felixzhong94/NVSL-quadcopter_lab5/PartList.xlsx

Description | DATASHEET | DIST | DISTPN | MFR | MPN | VALUE | Lab04 | Lab04a
Light emitting diode | http://media.digikey.com/pdf/Data%20Sheets/Lite-On%20PDFs/LTST-C170EKT.pdf | Digikey | 160-1178-1-ND | Lite-On Inc | LTST-C170EKT | red | x | x
Light emitting diode | http://media.digikey.com/pdf/Data%20Sheets/Lite-On%20PDFs/LTST-C170GKT.pdf | Digikey | 160-1179-1-ND | Lite-On Inc | LTST-C170GKT | green |  | x
Resistor | http://media.digikey.com/pdf/Data%20Sheets/Yageo%20PDFs/RC0805%20Pb%20Free.pdf | Digikey | 311-0.0ARCT-ND | Yageo | RC0805JR-070RL | 0 | x | x
Resistor | http://media.digikey.com/pdf/Data%20Sheets/Yageo%20PDFs/RC0805%20Pb%20Free.pdf | Digikey | 311-100ARCT-ND | Yageo | RC0805JR-07100RL | 100 |  | x
Resistor | http://media.digikey.com/pdf/Data%20Sheets/Yageo%20PDFs/RC0805%20Pb%20Free.pdf | Digikey | 311-10KARCT-ND | Yageo | RC0805JR-0710KL | 10K |  | x
Resistor | http://media.digikey.com/pdf/Data%20Sheets/Yageo%20PDFs/RC0805%20Pb%20Free.pdf | Digikey | 311-330ARCT-ND | Yageo | RC0805JR-07330RL | 330 |  | x
Resistor | http://media.digikey.com/pdf/Data%20Sheets/Yageo%20PDFs/RC0805%20Pb%20Free.pdf | Digikey | 311-5.1KARCT-ND | Yageo | RC0805JR-075K1L | 5.1K |  | x
2 pin single inline pin header, socket, or connector | http://multimedia.3m.com/mws/mediawebserver?66666UuZjcFSLXTtNxTElX&VEVuQEcuZgVs6EVs6E666666-- | Digikey | 3M9447-ND | 3M | 961102-6404-AR |  | x | x
Pushbutton with 2 pins shorting 1 to 2 and two extra mounting pins 3 & 4 | http://www.te.com/commerce/DocumentDelivery/DDEController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 | Digikey | 450-1129-ND | TE Connectivity Alcoswitch Switches | FSM4JSMA |  |  | x
Polarized capacitor | http://www.avx.com/docs/Catalogs/taj.pdf | Digikey | 478-1677-1-ND | AVX Corporation | TAJB107K006RNJ | 100uF | x | x
Polarized capacitor | http://www.avx.com/docs/Catalogs/taj.pdf | Digikey | 478-8912-1-ND | AVX Corporation | TAJD227K006RNJ | 220uF |  | x
Nonpolarized capacitor | http://www.murata.com/~/media/webrenewal/support/library/catalog/products/capacitor/mlcc/c02e.ashx | Digikey | 490-1666-1-ND | Murata Electronics North America | GRM21BR71H104KA01L | 0.1uF |  | x
Nonpolarized capacitor | http://www.murata.com/~/media/webrenewal/support/library/catalog/products/capacitor/mlcc/c02e.ashx | Digikey | 490-1670-1-ND | Murata Electronics North America | GRM21BR71H224KA01L | 0.22uF |  | x
Nonpolarized capacitor | http://www.murata.com/~/media/webrenewal/support/library/catalog/products/capacitor/mlcc/c02e.ashx | Digikey | 490-3335-1-ND | Murata Electronics North America | GRM21BR61E475KA12L | 4.7uF |  | x
Nonpolarized capacitor | http://search.murata.co.jp/Ceramy/image/img/A01X/G101/ENG/GQM2195C2AR75CB01-01.pdf | Digikey | 490-3585-1-ND | Murata Electronics North America | GQM2195C2AR75CB01D | 0.75pF |  | x
Nonpolarized capacitor | http://www.murata.com/~/media/webrenewal/support/library/catalog/products/capacitor/mlcc/c02e.ashx | Digikey | 490-4736-1-ND | Murata Electronics North America | GRM21BR71H105KA12L | 1uF |  | x
Nonpolarized capacitor | http://www.murata.com/~/media/webrenewal/support/library/catalog/products/capacitor/mlcc/c02e.ashx | Digikey | 490-5523-1-ND | Murata Electronics North America | GRM21BR61E106KA73L | 10uF |  | x
Nonpolarized capacitor | http://www.murata.com/~/media/webrenewal/support/library/catalog/products/capacitor/mlcc/c02e.ashx | Digikey | 490-5531-1-ND | Murata Electronics North America | GRM21A5C2E120JW01D | 12pF |  | x
Nonpolarized capacitor | http://www.murata.com/~/media/webrenewal/support/library/catalog/products/capacitor/mlcc/c02e.ashx | Digikey | 490-5534-1-ND | Murata Electronics North America | GRM21A5C2E220JW01D | 22pF |  | x
Nonpolarized capacitor | http://www.murata.com/~/media/webrenewal/support/library/catalog/products/capacitor/mlcc/c02e.ashx | Digikey | 490-8295-1-ND | Murata Electronics North America | GRM2195C1H103FA01D | 0.01uF |  | x
IMU | http://www.st.com/st-web-ui/static/active/en/resource/technical/document/datasheet/DM00087365.pdf | Digikey | 497-13902-1-ND | STMicroelectronics | LSM9DS0TR |  | x | x
Various standard crystals. Proven footprints. | http://www.abracon.com/Resonators/abm3b.pdf | Digikey | 535-9122-1-ND | Abracon LLC | ABM3B-16.000MHZ-B2-T |  |  | x
AVR ISP 6 Pin | http://portal.fciconnect.com/Comergent//fci/drawing/67996.pdf | Digikey | 609-3234-ND | Amphenol FCI | 67997-206HLF |  |  | x
10 pin single inline pin header, socket, or connector | http://portal.fciconnect.com/Comergent//fci/drawing/68000.pdf | Digikey | 609-3250-ND | Amphenol FCI | 68000-110HLF |  |  | x
FTDI Basic header with labels | http://portal.fciconnect.com/Comergent//fci/drawing/68015.pdf | Digikey | 609-3327-ND | Amphenol FCI | 68016-406HLF |  |  | x
0805 footprint balun- Ember 351/357 | http://katalog.we-online.de/pbs/datasheet/748421245.pdf | Digikey | 732-2230-6-ND | Wurth Electronics Inc | 748421245 |  |  | x
Chip antenna | http://www.linxtechnologies.com/resources/data-guides/ant-xxx-chp-x.pdf | Digikey | ANT-2.45-CHPCT-ND | Linx Technologies Inc. | ANT-2.45-CHP-T |  |  | x
ATmega128RFA1 | http://www.atmel.com/Images/Atmel-8266-MCU_Wireless-ATmega128RFA1_Datasheet.pdf | Digikey | ATMEGA128RFA1-ZUR00DKR-ND | Atmel | ATMEGA128RFA1-ZUR00 |  |  | x
Schottky diode | http://www.toshiba.com/taec/components2/Datasheet_Sync/200612/DST_CRS08-TDE_EN_1640.pdf | Digikey | CRS08QMCT-ND | Toshiba Semiconductor and Storage | CRS08(TE85L,Q,M) | 360mV |  | x
Voltage regulator (3.0V) | http://www.ti.com/lit/ds/symlink/lp3985.pdf | Digikey | LP3985IM5X-3.0/NOPBCT-ND | Texas Instruments | LP3985IM5X-3.0/NOPB |  |  | x
Generic N-Channel MOSFET | http://www.vishay.com/docs/68645/si2302cds.pdf | Digikey | SI2302CDS-T1-E3CT-ND | Vishay Siliconix | SI2302CDS-T1-E3 | 2.6A | x | x
Battery holder | See replacement body in crash kit
Motor connector | 2 SMDs (one negative, one positive) 2-3mm on a side 2 mm between them. |  |  |  |  |  |  | x
RGB Led | http://www.qt-brightek.com/datasheet/QBLP679E-RGB.pdf | Digikey | 1516-1131-1-ND | QT Brightek (QTB) | QBLP679E-RGB
