felixzhong94/NVSL-quadcopter_lab5/tapeout/xuefei_zhiye-lab7.brd

## EAGLE design tapeout/xuefei_zhiye-lab7.brd (2016-05-17)

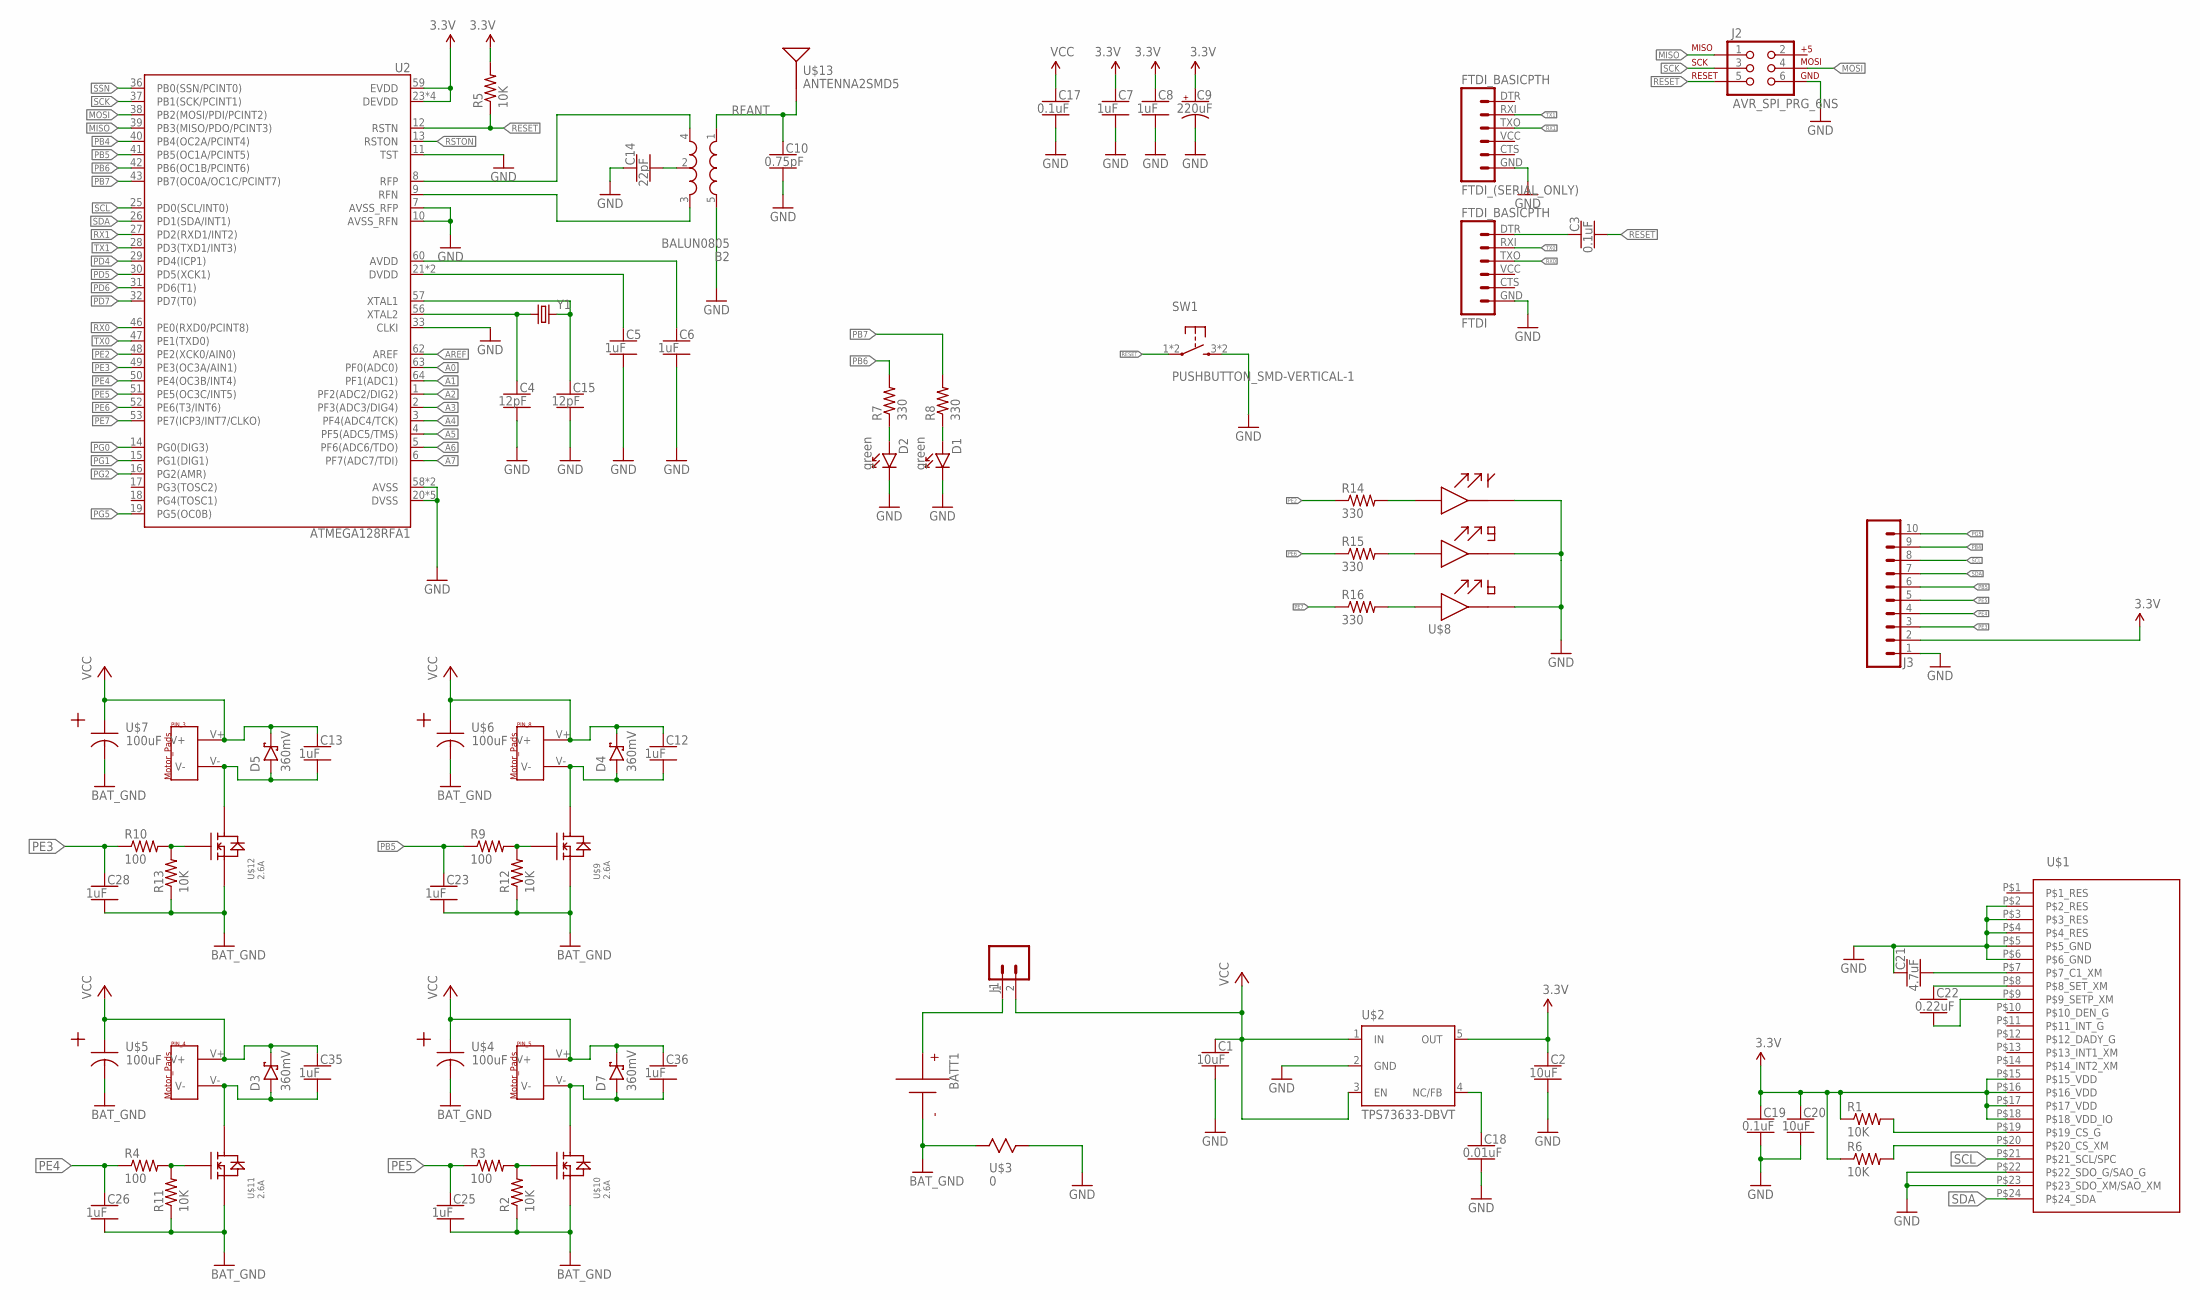
[picture p1: schematic xuefei_zhiye-lab7.sch]

Parts:
B2: BALUN0805; BALUN
BATT1: BATTERY-HUBSAN-W/HOLDER; BATTERY-W/HOLDER-380MAH-HUBSAN
C1, C2, C20: 10uF; CAPC2012X140_HS
C3, C17, C19: 0.1uF; CAPC2012X140_HS
C4, C15: 12pF; CAPC2012X140_HS
C5, C6, C7, C8, C12, C13, C23, C25, C26, C28, C35, C36: 1uF; CAPC2012X140_HS
C9: 220uF; CAPMP7343X310_HS
C10: 0.75pF; CAPC2012X140_HS
C14: 22pF; CAPC2012X140_HS
C18: 0.01uF; CAPC2012X140_HS
C21: 4.7uF; CAPC2012X140_HS
C22: 0.22uF; CAPC2012X140_HS
D1, D2: green; LEDSC125X200X120-2_HS
D3, D4, D5, D7: 360mV; SOD3716X135_HS
FTDI: FTDI_BASICPTH; FTDI_BASIC
FTDI_(SERIAL_ONLY): FTDI_BASICPTH; FTDI_BASIC
J1: MALE_HEADER_2POS-2X1-0.1IN; MALE_HEADER_2X1_0.1IN
J2: AVR_SPI_PRG_6NS; 2X3-NS
J3: SIP-10_TH-254X10-1; HDRV10W63P254_10X1_2540X254H838_HS
PIN_3, PIN_4, PIN_5, PIN_8: MOTOR_PADS
R1, R2, R5, R6, R11, R12, R13: 10K; RESC2012X60_HS
R3, R4, R9, R10: 100; RESC2012X60_HS
R7, R8, R14, R15, R16: 330; RESC2012X60_HS
SW1: PUSHBUTTON_SMD-VERTICAL-1; TE_FSM8JSMA_HS
U2: ATMEGA128RFA1; QFN-64
U$1: IMU; LGA-24_4X4MM
U$2: TPS73633-DBVT; SOT23-DBV
U$3: 0; SMD_RESISTOR
U$4, U$5, U$6, U$7: 100uF; TAJB_SMB_POLAR_CAP
U$8: QBLP679E-RGB
U$9, U$10, U$11, U$12: 2.6A; LITTLE_FOOT_MOSFET_W/_HEAT_SPREADER
U$13: ANTENNA2SMD5; ANTENNA-CHIP5
Y1: CRYSTAL5X3; CRYSTAL-SMD-5X3

Connections:
3.3V: C2.1, C7.1, C8.1, C9.1 (+), C19.1, C20.1, J3.2, R1.1, R5.2, R6.1, U2.23 (DEVDD), U2.34 (DEVDD), U2.44 (DEVDD), U2.54 (DEVDD), U2.59 (EVDD), U$1.P$15 (P$15_VDD), U$1.P$16 (P$16_VDD), U$1.P$17 (P$17_VDD), U$1.P$18 (P$18_VDD_IO), U$2.5 (OUT)
A0: U2.63 (PF0(ADC0))
A1: U2.64 (PF1(ADC1))
A2: U2.1 (PF2(ADC2/DIG2))
A3: U2.2 (PF3(ADC3/DIG4))
A4: U2.3 (PF4(ADC4/TCK))
A5: U2.4 (PF5(ADC5/TMS))
A6: U2.5 (PF6(ADC6/TDO))
A7: U2.6 (PF7(ADC7/TDI))
AREF: U2.62 (AREF)
AVDD: C6.1, U2.60 (AVDD)
BAT_GND: BATT1.- (N), C23.2, C25.2, C26.2, C28.2, R2.1, R11.1, R12.1, R13.1, U$3.P$1, U$4.P$2 (2), U$5.P$2 (2), U$6.P$2 (2), U$7.P$2 (2), U$9.P$2 (P$2_S), U$10.P$2 (P$2_S), U$11.P$2 (P$2_S), U$12.P$2 (P$2_S)
DTR: C3.1, FTDI.DTR (1)
DVDD: C5.1, U2.21 (DVDD), U2.22 (DVDD)
GND: B2.5 (GND), C1.2, C2.2, C4.2, C5.2, C6.2, C7.2, C8.2, C9.2 (-), C10.2, C14.1, C15.2, C17.2, C18.2, C19.2, C20.2, C21.1, D1.C, D2.C, FTDI.GND (6), FTDI_(SERIAL_ONLY).GND (6), J2.6, J3.1, SW1.3 (2), SW1.4 (2), U2.7 (AVSS_RFP), U2.10 (AVSS_RFN), U2.11 (TST), U2.20 (DVSS), U2.24 (DVSS), U2.33 (CLKI), U2.35 (DVSS), U2.45 (DVSS), U2.55 (DVSS), U2.58 (AVSS), U2.61 (AVSS), U$1.P$2 (P$2_RES), U$1.P$3 (P$3_RES), U$1.P$4 (P$4_RES), U$1.P$5 (P$5_GND), U$1.P$6 (P$6_GND), U$1.P$22 (P$22_SDO_G/SAO_G), U$1.P$23 (P$23_SDO_XM/SAO_XM), U$2.2 (GND), U$3.P$2, U$8.P$1, U$8.P$2, U$8.P$3
MISO: J2.1, U2.39 (PB3(MISO/PDO/PCINT3))
MOSI: J2.4, U2.38 (PB2(MOSI/PDI/PCINT2))
unnamed: R14.2, U$8.P$4
unnamed: R15.2, U$8.P$5
unnamed: C15.1, U2.57 (XTAL1), Y1.3 (2)
unnamed: C4.1, U2.56 (XTAL2), Y1.1
unnamed: C18.1, U$2.4 (NC/FB)
unnamed: C21.2, U$1.P$7 (P$7_C1_XM)
unnamed: B2.2 (GND), C14.2
unnamed: D2.A, R7.1
unnamed: R16.2, U$8.P$6
unnamed: C22.1, U$1.P$8 (P$8_SET_XM)
unnamed: D1.A, R8.1
unnamed: C22.2, U$1.P$9 (P$9_SETP_XM)
unnamed: R1.2, U$1.P$19 (P$19_CS_G)
unnamed: R6.2, U$1.P$20 (P$20_CS_XM)
unnamed: BATT1.+, J1.1
unnamed: R9.2, R12.2, U$9.P$1 (P$1_G)
unnamed: C12.2, D4.A, PIN_8.V-, U$9.P$3 (P$3_D)
unnamed: R2.2, R3.2, U$10.P$1 (P$1_G)
unnamed: C36.2, D7.A, PIN_5.V-, U$10.P$3 (P$3_D)
unnamed: R10.2, R13.2, U$12.P$1 (P$1_G)
unnamed: C13.2, D5.A, PIN_3.V-, U$12.P$3 (P$3_D)
unnamed: R4.2, R11.2, U$11.P$1 (P$1_G)
unnamed: C35.2, D3.A, PIN_4.V-, U$11.P$3 (P$3_D)
PB4: J3.9, U2.40 (PB4(OC2A/PCINT4))
PB5: C23.1, J3.6, R9.1, U2.41 (PB5(OC1A/PCINT5))
PB6: R7.2, U2.42 (PB6(OC1B/PCINT6))
PB7: R8.2, U2.43 (PB7(OC0A/OC1C/PCINT7))
PD4: U2.29 (PD4(ICP1))
PD5: U2.30 (PD5(XCK1))
PD6: U2.31 (PD6(T1))
PD7: U2.32 (PD7(T0))
PE2: R14.1, U2.48 (PE2(XCK0/AIN0))
PE3: C28.1, J3.3, R10.1, U2.49 (PE3(OC3A/AIN1))
PE4: C26.1, J3.4, R4.1, U2.50 (PE4(OC3B/INT4))
PE5: C25.1, J3.5, R3.1, U2.51 (PE5(OC3C/INT5))
PE6: R15.1, U2.52 (PE6(T3/INT6))
PE7: R16.1, U2.53 (PE7(ICP3/INT7/CLKO))
PG0: U2.14 (PG0(DIG3))
PG1: U2.15 (PG1(DIG1))
PG2: U2.16 (PG2(AMR))
PG5: J3.10, U2.19 (PG5(OC0B))
RESET: C3.2, J2.5, R5.1, SW1.1, SW1.2 (1), U2.12 (RSTN)
RFANT: B2.1 (IN), C10.1, U$13.FEED
RFN: B2.3 (OUT2), U2.9 (RFN)
RFP: B2.4 (OUT1), U2.8 (RFP)
RSTON: U2.13 (RSTON)
RX0: FTDI.TXO (3), U2.46 (PE0(RXD0/PCINT8))
RX1: FTDI_(SERIAL_ONLY).TXO (3), U2.27 (PD2(RXD1/INT2))
SCK: J2.3, U2.37 (PB1(SCK/PCINT1))
SCL: J3.8, U2.25 (PD0(SCL/INT0)), U$1.P$21 (P$21_SCL/SPC)
SDA: J3.7, U2.26 (PD1(SDA/INT1)), U$1.P$24 (P$24_SDA)
SSN: U2.36 (PB0(SSN/PCINT0))
TX0: FTDI.RXI (2), U2.47 (PE1(TXD0))
TX1: FTDI_(SERIAL_ONLY).RXI (2), U2.28 (PD3(TXD1/INT3))
VCC: C1.1, C12.1, C13.1, C17.1, C35.1, C36.1, D3.C, D4.C, D5.C, D7.C, J1.2, PIN_3.V+, PIN_4.V+, PIN_5.V+, PIN_8.V+, U$2.1 (IN), U$2.3 (EN), U$4.P$1 (1), U$5.P$1 (1), U$6.P$1 (1), U$7.P$1 (1)

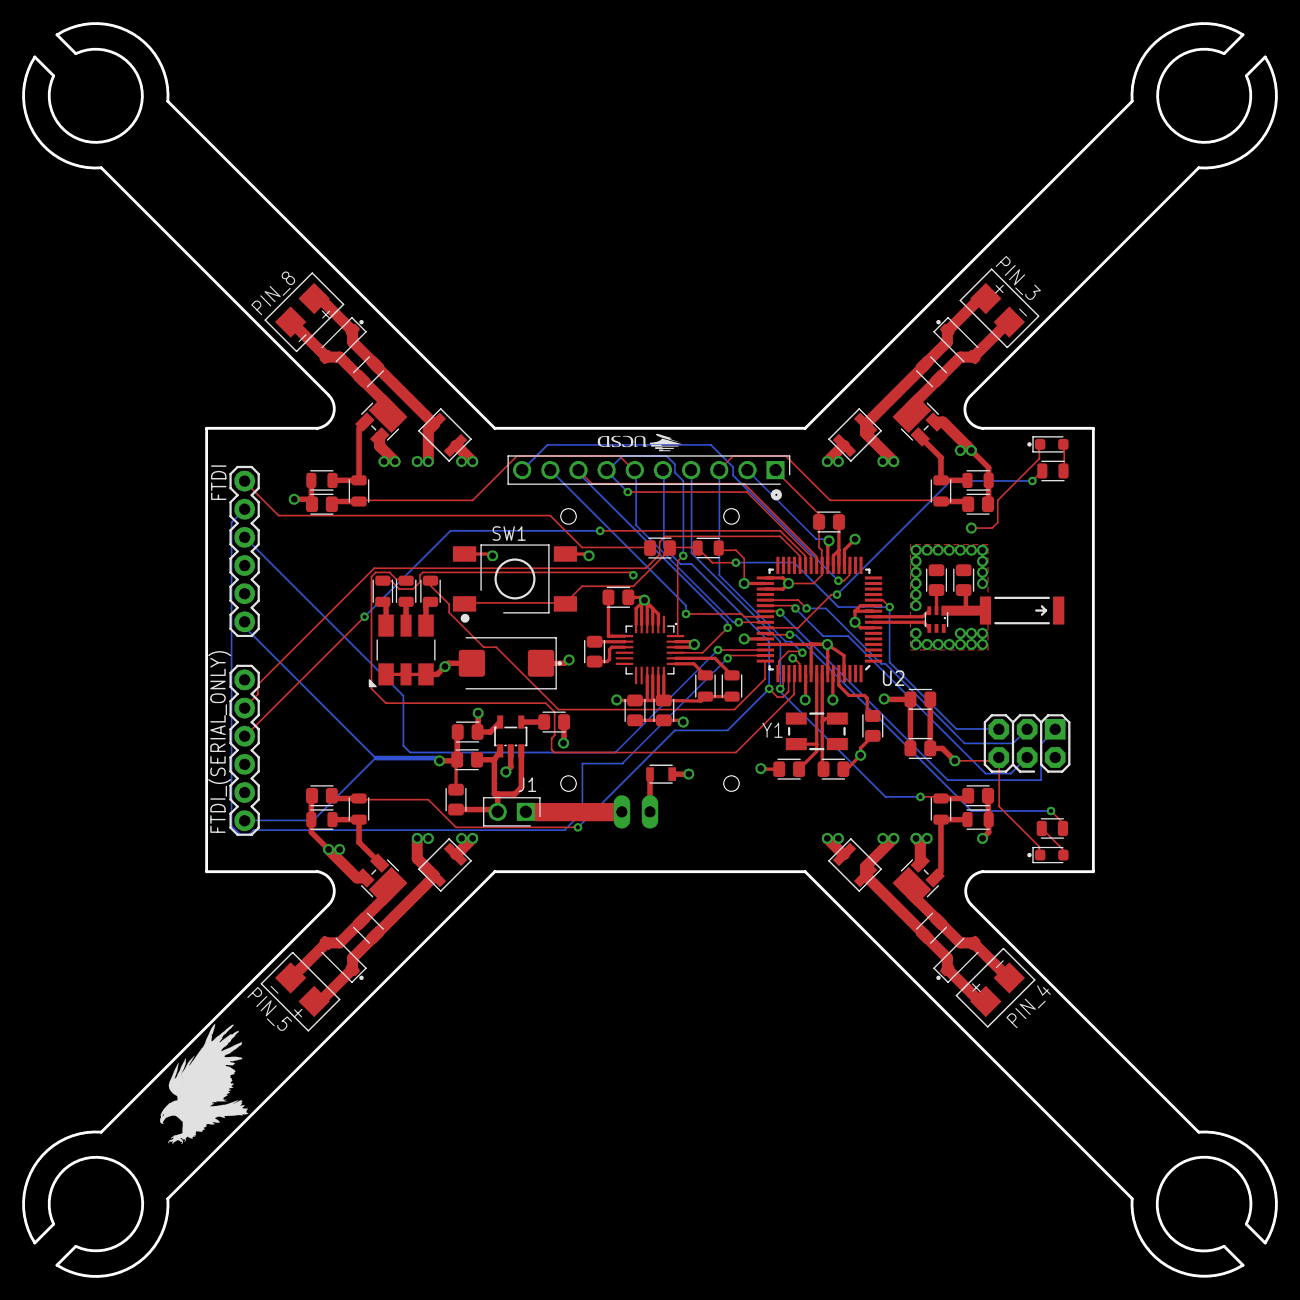
[picture p2: board xuefei_zhiye-lab7.brd from above]

Board: 4 copper layers, 113.0 x 113.0 mm, 77 parts (1 on the bottom side), 54 nets.

Other parts of the board:
U$14: UCSD_LOGO
U$15: EAGLE-PLC-8MM
