felixzhong94/NVSL-quadcopter_lab5/(commit log)

2016-04-20 added base
    [ATmega128RFA1-DevBoard.brd, ATmega128RFA1-DevBoard.sch]
2016-04-21 added and wired imu
    [ATmega128RFA1-DevBoard.brd, ATmega128RFA1-DevBoard.sch, PartList.xlsx]
2016-04-21 added motor controller
    [ATmega128RFA1-DevBoard.brd, ATmega128RFA1-DevBoard.sch]
2016-04-21 added bigger cap to power supply
    [ATmega128RFA1-DevBoard.brd, ATmega128RFA1-DevBoard.sch]
2016-04-21 added tags
    [ATmega128RFA1-DevBoard.brd, ATmega128RFA1-DevBoard.sch]
2016-04-22 clear up of motor driver layout
    [ATmega128RFA1-DevBoard.brd, ATmega128RFA1-DevBoard.sch]
2016-04-26 changed component on motor driver
    [ATmega128RFA1-DevBoard.brd, ATmega128RFA1-DevBoard.sch]
2016-04-26 devboard changes
    [ATmega128RFA1-DevBoard.brd, ATmega128RFA1-DevBoard.sch]
2016-04-29 Reviewed on board schematic and documentations
2016-05-02 added rgb led and removed unneeded files
2016-05-03 Made corrections
    [quadcopter.brd, quadcopter.sch]
2016-05-05 parts placed
    [quadcopter.brd]
2016-05-05 POURED SHIELDING FOR ANT
    [quadcopter.brd, quadcopter.sch]
2016-05-05 FIXED SOME POURS
    [ATmega128RFA1-DevBoard.sch, quadcopter.brd, quadcopter.sch]
2016-05-07 For Design Review
    [ATmega128RFA1-DevBoard.brd, ATmega128RFA1-DevBoard.sch, quadcopter.brd, quadcopter.sch]
2016-05-08 fixed/corrected library fields
    [PartList.xlsx]
2016-05-08 Updated board with new prebuilt library and resolved keep-out conflicts
    [xuefei-lab7.brd, xuefei-lab7.sch]
2016-05-12 Applied update to library and dru files. Passing DFM testing
    [quadcopter.brd, quadcopter.sch, xuefei-lab7.brd, xuefei-lab7.sch]
2016-05-17 fixed outline
    [quadcopter.brd]
2016-05-17 fixed imu smd width
    [quadcopter.brd, quadcopter.sch]
